LeifBloomquist/WiFiModem/README.md

# WiFiCart
WiFi Cart for the Commodore 64 with MicroView
