LeifBloomquist/WiFiModem/Documents/misc/Wi-Fi Modem BOM.xlsx

# | ID | Name | Quantity | Usage | Vendor | Part# | Link | Notes
1 | - | PCB | 1 | Custom Printed Circuit Board | Hackvana |  | http://www.jammingsignal.com
2 | - | MicroView | 1 | Hayes Emulation and Display | Sparkfun |  | https://www.sparkfun.com/products/12923
3 | - | RN-XV | 1 | Wi-Fi Interface | Sparkfun |  | https://www.sparkfun.com/products/10822
4 | U2 | MCP-1700 3302 | 1 | 5V to 3.3V Regulator | Digikey | MCP1700-3302E/TO | http://www.digikey.ca/product-detail/en/0/MCP1700-3302E%2fTO-ND
5 | C1 | Ceramic Capacitor | 0* | Smoothing for Regulator |  |  |  | As recommended by MCP1700 Datasheet
6 | - | Reset Button | 3 | Reset C64, MicroView, RN-XV | Creatron | SWTAC-000004 | https://www.creatroninc.com/product/small-tactile-switch-6mm/
7 | U1 | Resistor Network | 1 | Current Limiting 100 Ohm) | Digikey | 4116R-1-101LF
8 | VIN | Power Connector | 1 | DC Power VIN for Standalone Use | Digikey | CP-102AH-ND | https://www.digikey.ca/product-detail/en/PJ-102AH/CP-102AH-ND/408448 | Not soldered
9 |  | User Port Connector | 1 | Connect to C64 | AAA Scrap Dogs Unlimited |  | http://stores.ebay.ca/AAA-SCRAP-DOGS-UNLIMITED
10 |  | MicroView Header | 0* | Interface MicroView to external stuff |  |  |  | *Optional
11 |  | Socket | 1 | Socket for resistor network | Digikey | 609-4713-ND | http://www.digikey.ca/product-detail/en/0/609-4713-ND
12 |  | MicroView Socket | 2 | Socket for MicroView | Digikey | S7006-ND | http://www.digikey.ca/product-detail/en/0/S7006-ND
13 |  | RN-XV Socket | 2 | Socket for RN-XV | Digikey | S5751-10-ND | http://www.digikey.ca/product-detail/en/0/S5751-10-ND
14 |  | M3 13mm Standoffs | 4 | Standoffs with Nuts | Creatron |  | https://www.creatroninc.com
15 |  | Jumpers | 2 | Jumpers for Wi-Fi Direct Connect | Creatron
16 |  | MicroView Programmer | 1 | Programming MicroView | Sparkfun |  | https://www.sparkfun.com/products/12924 | Separate Component
