LeifBloomquist/WiFiModem/(list of files, drawings)

Other design files:
Hardware/Microview C64 WiFi Cart R54 1v0.fzz
Hardware/Microview C64 WiFi Cart R57 1v1.fzz
