LeifBloomquist/WiFiModem/(commit log)

2015-09-23 Hayesduino+Switch to Visual Micro
    [Wi-Fi Modem BOM.xlsx]
2015-09-30 Flow control and config changes
2015-10-08 Misc Fixes and Test Program
    [WiFiModem-Hayes.ino, WiFiModem-Menu.ino]
2015-10-08 Flow control works!
2015-10-08 Flow Control Doc Updates
2015-10-29 Many Fixes and Documentation
    [Wi-Fi Modem BOM.xlsx]
2015-11-03 Misc fixes and documentation
    [WiFiModem-Menu.ino]
2015-11-19 Change to version 0.5b1. Fix AT buffer overflow.
    [WiFiModem-Menu.ino]
2015-11-19 Add &k0 &k1 AT commands for RTS/CTS disable/enable. Add flow control to AT command mode.
2015-11-21 Fix Hayes random crash/reboot, fix Hayes dialing from terminal program (add delay), re-org Modem_Loop (needs review).
    [WiFiModem-Menu.ino]
2015-11-23 Documentation cleanup
    [Wi-Fi Modem BOM.xlsx]
2015-11-24 Add ATDL redial, add ATE? and AT&K? to get current values.
2015-11-27 Add baud rate selection menu for 1200/2400/9600 and save to eeprom. Remove at&w0/&v and recovery to save space. Still too big for Hayes to compile.
    [WiFiModem-Menu.ino]
2015-11-28 Remove autoconfigure from Hayes to save space, using main() again, minor fixes
    [WiFiModem-Menu.ino]
2015-11-29 Add +++ to hang up, Hayes: Phone book with auto start: at&pb#=, at&pbauto=, at&pb?, atd##, Menu: Changing SSID no longer reboots & activates immediately
    [WiFiModem-Menu.ino]
2015-11-29 Fix +++ logic and change guard time to 1 second.
    [WiFiModem-Menu.ino]
2015-12-03 AT command improvements / fixes
    [WiFiModem-Menu.ino]
2015-12-04 Fix for telnet detection, allow spaces in addresses, NO CARRIER message for connect failures, save Q, S, V, S0 to EEPROM, fix Quiet mode.
    [WiFiModem-Menu.ino]
2015-12-04 SSID change modified to report error on join instead of setting SSID, fix for garbled MAC address printout at boot, incoming port code only reboots if code changes and prompts if >2400 baud. Menu: Ad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
    [WiFiModem-Menu.ino]
2015-12-15 AT command output cleanup, bi-directional flow control for menu and Hayes mode.
2015-12-15 menu: cr/lf fix for ASCII, Hayes: at command always ASCII response output, default phone book entries, non-ascii character fix.
    [WiFiModem-Menu.ino]
2015-12-17 Fix for &pbclear default entries
    [WiFiModem-Menu.ino]
2015-12-19 Hayes: Add phone book dial atdp#x, atdt#x, fix bbs address, at&pbx now gives error.
    [WiFiModem-Menu.ino]
2016-01-03 Fix for C64 to modem flow control
    [WiFiModem-Menu.ino]
2016-01-03 Menu flow c64 to modem, +++ guard cmd mode for outbound.
2016-01-04 Remove dead code, fix formatting.
    [WiFiModem-Menu.ino]
2016-01-07 ATS2, ATX, Flow, 1200 baud, LICENSE, RAM util.
2016-01-29 AT&S, SSID save fix, DCD invert, Telnet detection.
    [WiFiModem-Menu.ino]
2016-01-30 OK/ERROR response fixes, petscii updates
    [WiFiModem-Menu.ino, petscii.cpp, petscii.h]
2016-02-05 Cleanup, fix at&k and atv
    [WiFiModem-Menu.ino]
2016-02-13 Comment cleanup, code shrink, ats2 with * fix
    [WiFiModem-Menu.ino]
2016-02-24 Fix CommodoreServer 38.8, code cleanup
    [WiFiModem-Menu.ino]
2016-02-24 Modem loop fix, cleanup.
    [WiFiModem-Menu.ino]
2016-10-08 C128 / MacOS tools
    [Wi-Fi Modem BOM.xlsx]
2016-10-08 Added Fritzing files
    [Microview C64 WiFi Cart R54 1v0.fzz, Microview C64 WiFi Cart R57 1v1.fzz]
