LeifBloomquist/WiFiModem/(notices)

Notices in the files:
MicroView/WiFiModem-Menu/petscii.cpp:
This program is free software; you can redistribute it and/or modify
it under the terms of the GNU General Public License version 2
